KidInASquid/STeeringWheel/STeering_wheel.png

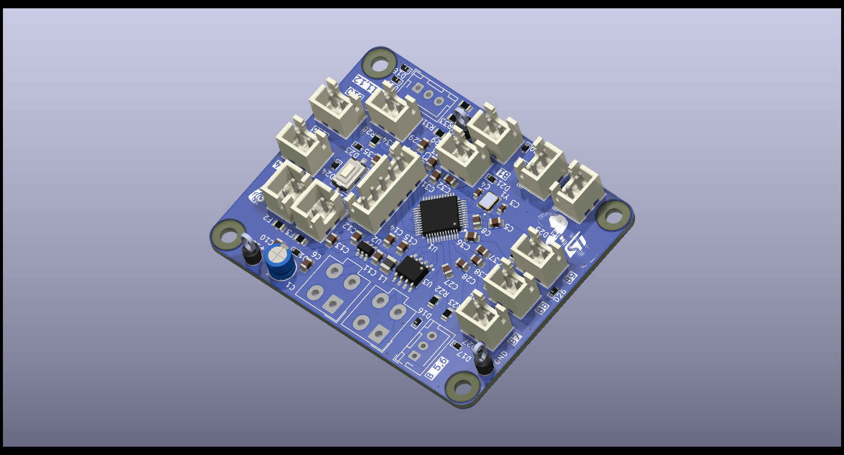
STeering_wheel.png
