KidInASquid/STeeringWheel/Base.step

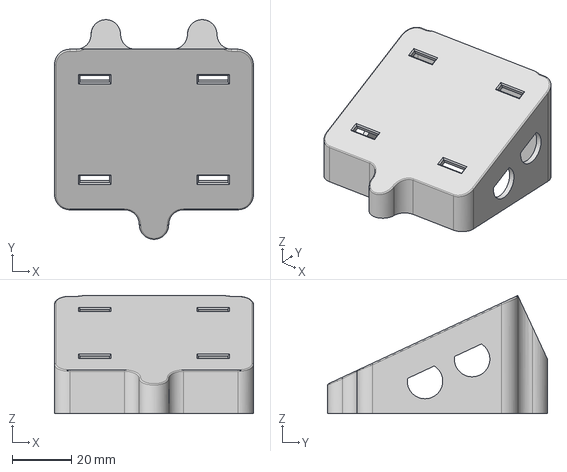
[picture p2: CAD file, 2025-04-29]
Base.step
67.4 x 74.4 x 40.0 mm
