KidInASquid/STeeringWheel/Lid.step

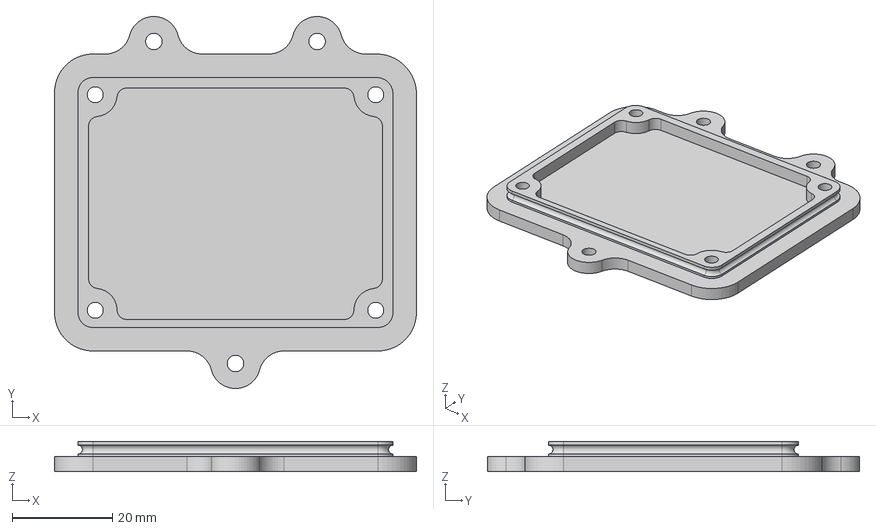
[picture p3: CAD file, 2025-04-29]
Lid.step
72.4 x 74.4 x 6.00 mm
