KidInASquid/STeeringWheel/PCB.pdf

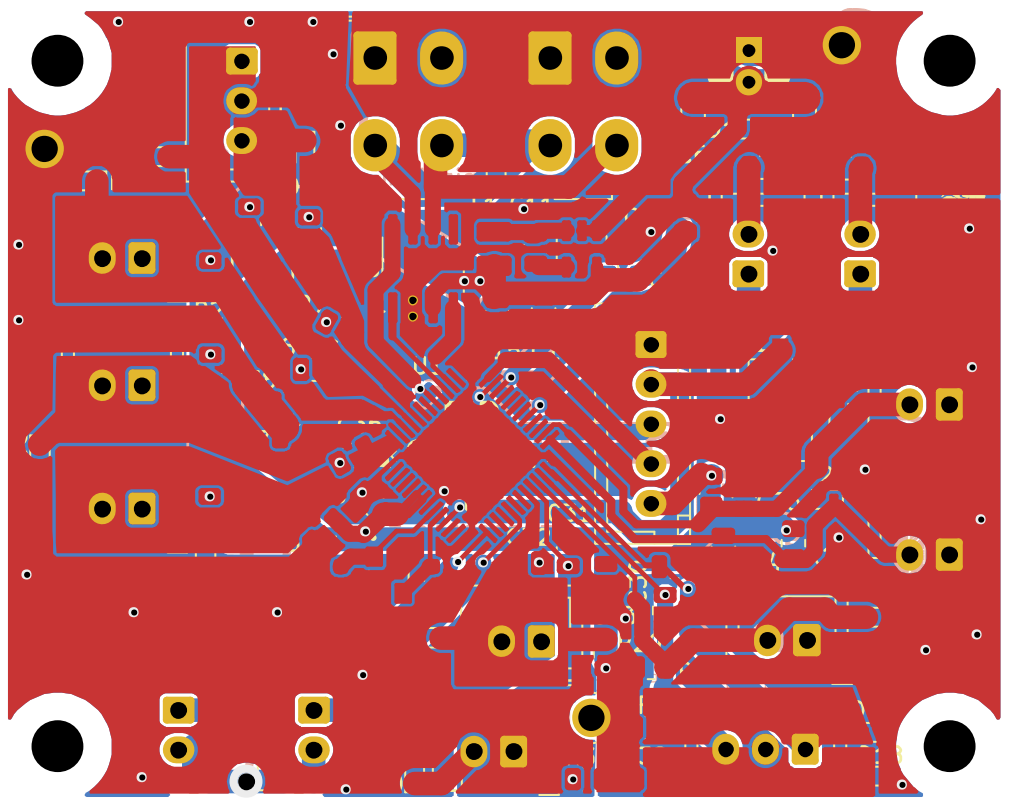
[picture p19: page 1]
