KidInASquid/STeeringWheel/KiCAD files/STeering_wheel.kicad_pcb

## KiCad design KiCAD files/STeering_wheel.kicad_pcb (2025-04-29)

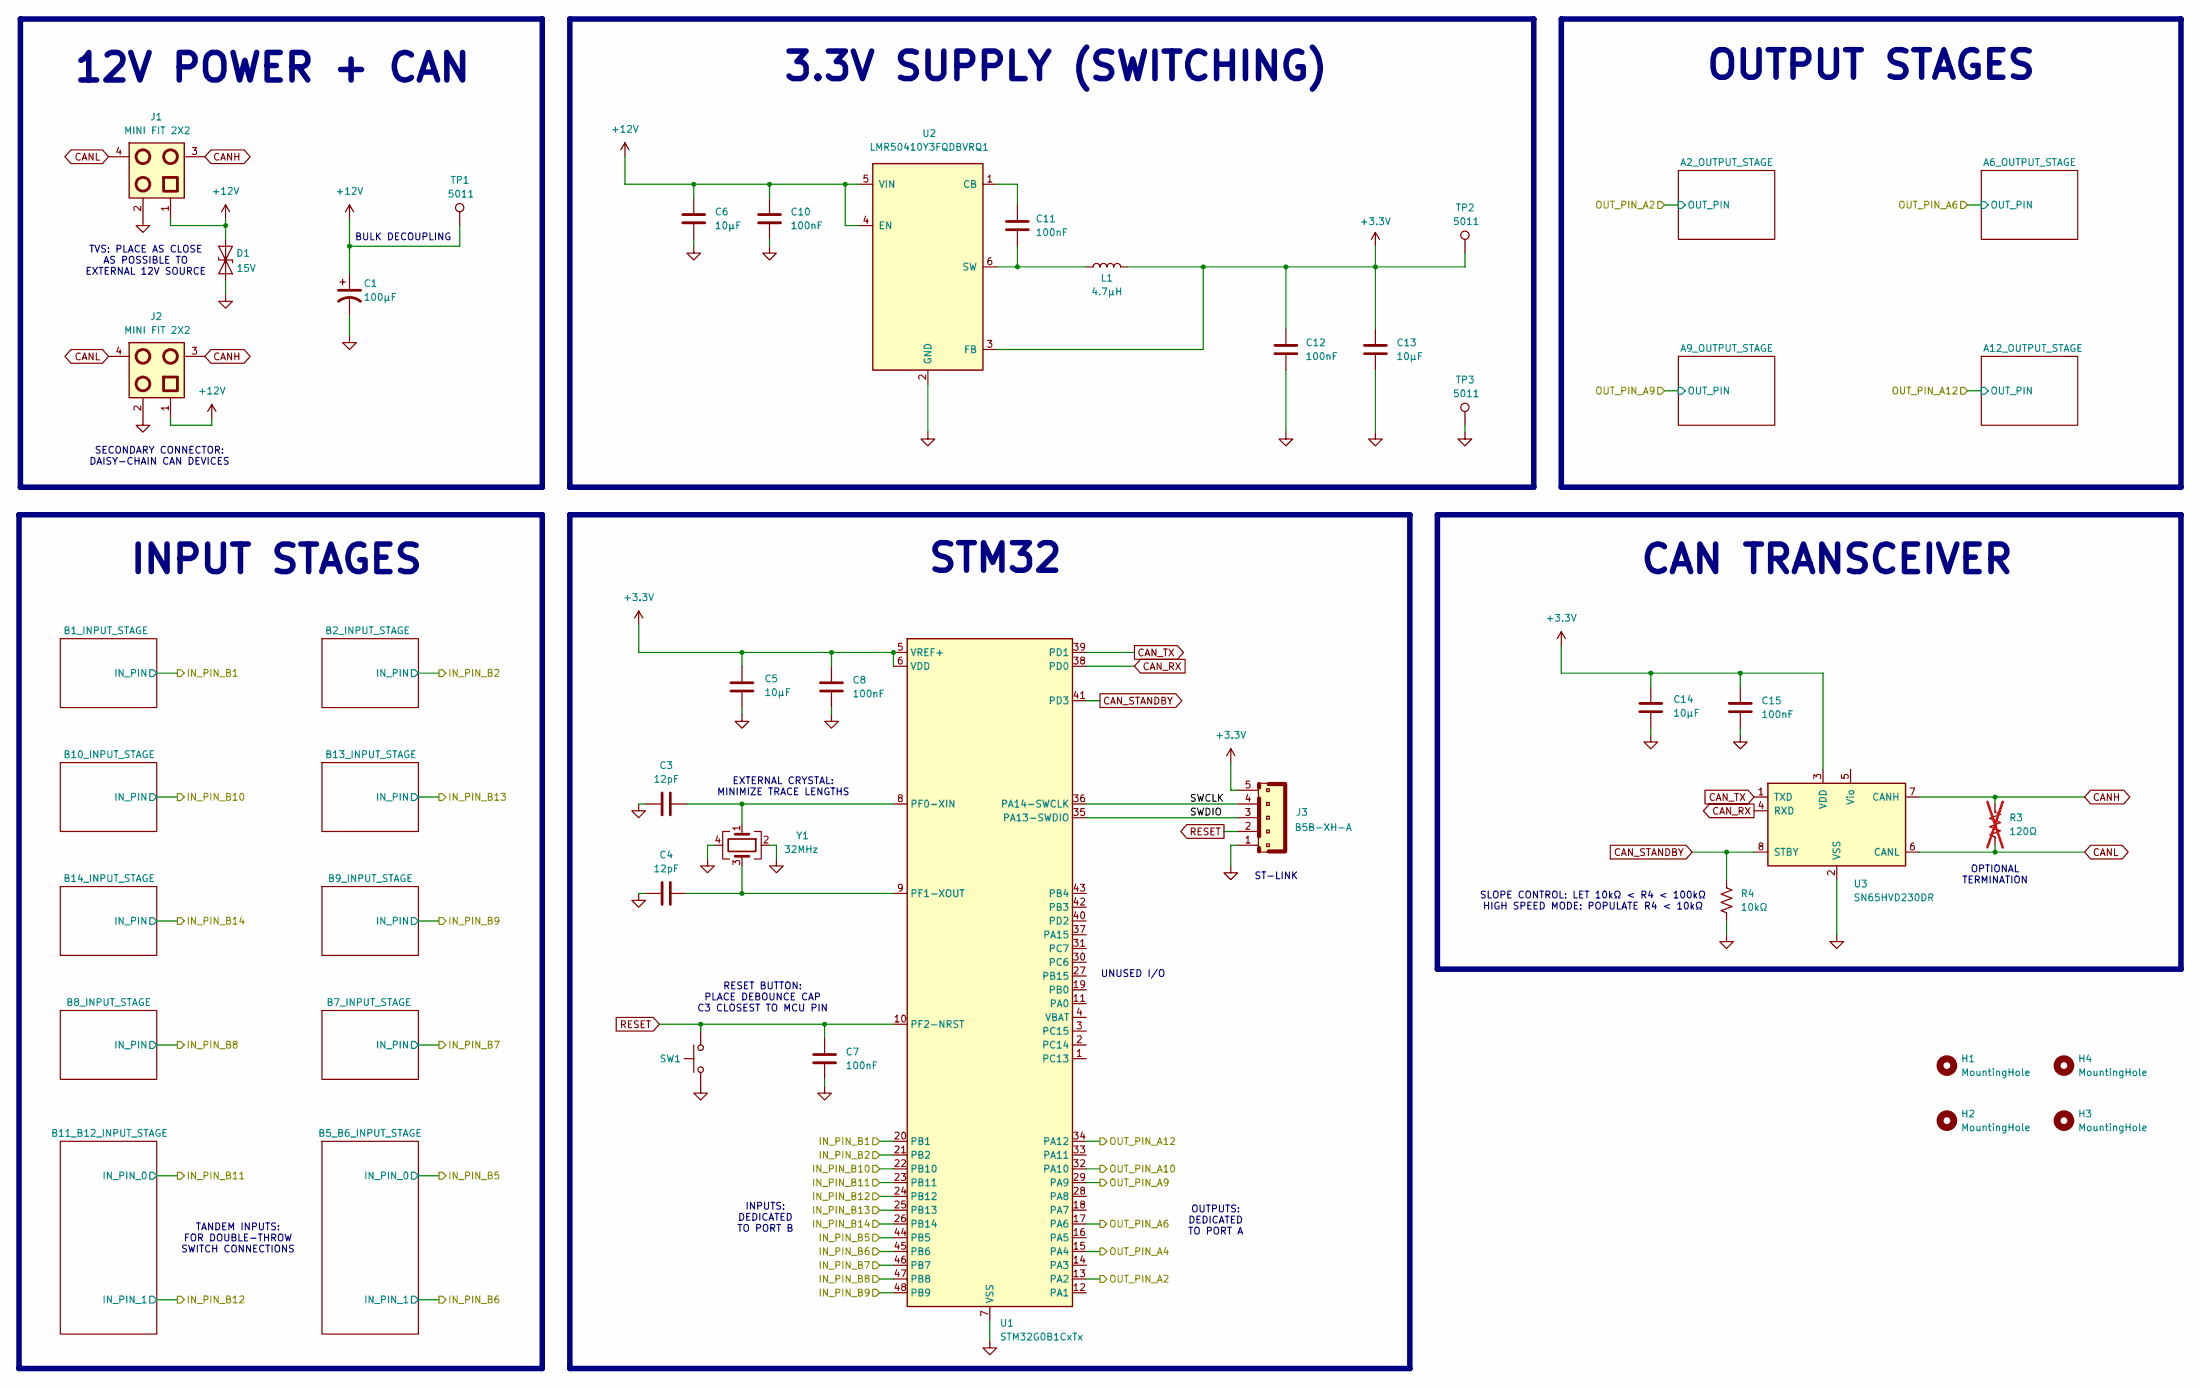
[picture p20: schematic STeering_wheel.kicad_sch, Steering Wheel STM32 CAN Module]

Parts:
C1: 100μF; CP_Radial_D5.0mm_P2.00mm; DigiKey Part Number P10369CT-ND
C3, C4: 12pF; C_0603_1608Metric; DigiKey Part Number 4713-CHV0805N250120FCT-ND
C5, C6, C13, C14: 10µF; C_0805_2012Metric; DigiKey Part Number 1276-1096-1-ND
C7, C8, C10, C11, C12, C15: 100nF; C_0805_2012Metric; DigiKey Part Number 1276-2442-1-ND
D1: AQHV15-01LTG-C; D_SOD-523; DigiKey Part Number AQHV15-01LTG-CCT-ND
H1, H2, H3, H4: MountingHole; MountingHole_3.2mm_M3_isolated_clearance
J1, J2: MINI FIT 2X2; Molex_Mini-Fit_Jr_5566-04A_2x02_P4.20mm_Vertical; DigiKey Part Number WM13112-ND
J3: B5B-XH-A; JST_XH_B5B-XH-A_1x05_P2.50mm_Vertical; DigiKey Part Number 455-B5B-XH-A-ND
L1: 4.7µH; L_1008_2520Metric; DigiKey Part Number 3526-WIP252010S-4R7MLDGCT-ND
R3: 120Ω; R_0805_2012Metric; DigiKey Part Number 2019-RK73H2ATTD1200FCT-ND; not fitted
R4: 10kΩ; R_0805_2012Metric; DigiKey Part Number 2019-RK73B2ATTD103JCT-ND
SW1: PTS636 SL50 SMTR LFS; SW_Tactile_SPST_NO_Straight_CK_PTS636Sx25SMTRLFS; DigiKey Part Number CKN12313-1-ND
TP1, TP2, TP3: 5011; keystone_5011_testpoint; DigiKey Part Number 36-5011-ND
U1: STM32G0B1CxTx; LQFP-48_7x7mm_P0.5mm; DigiKey Part Number 497-STM32G0B1KCT6-ND
U2: LMR50410Y3FQDBVRQ1; SOT-23-6; DigiKey Part Number 296-LMR50410Y3FQDBVRQ1CT-ND
U3: SN65HVD230DR; SOIC-8_3.9x4.9mm_P1.27mm_with_via_in_pads; DigiKey Part Number 296-11654-1-ND
Y1: 32MHz; XTAL_ECS-320-12-33B-7KM-TR; DigiKey Part Number 50-ECS-320-12-33B-7KM-CT-ND

Connections:
+3.3V: C5.1, C8.1, C12.1, C13.1, C14.1, C15.1, J3.5, L1.2, TP2.1, U1.5 (VREF+), U1.6 (VDD), U2.3 (FB), U3.3 (VDD); also elsewhere on the board
+12V: C1.1, C6.1, C10.1, D1.1 (A1), J1.1, J2.1, TP1.1, U2.4 (EN), U2.5 (VIN); also elsewhere on the board
/IN_PIN_B1: U1.20 (PB1); also elsewhere on the board
/IN_PIN_B2: U1.21 (PB2); also elsewhere on the board
/IN_PIN_B5: U1.44 (PB5); also elsewhere on the board
/IN_PIN_B6: U1.45 (PB6); also elsewhere on the board
/IN_PIN_B7: U1.46 (PB7); also elsewhere on the board
/IN_PIN_B8: U1.47 (PB8); also elsewhere on the board
/IN_PIN_B9: U1.48 (PB9); also elsewhere on the board
/IN_PIN_B10: U1.22 (PB10); also elsewhere on the board
/IN_PIN_B11: U1.23 (PB11); also elsewhere on the board
/IN_PIN_B12: U1.24 (PB12); also elsewhere on the board
/IN_PIN_B13: U1.25 (PB13); also elsewhere on the board
/IN_PIN_B14: U1.26 (PB14); also elsewhere on the board
/OUT_PIN_A2: U1.13 (PA2); also elsewhere on the board
/OUT_PIN_A4: U1.15 (PA4)
/OUT_PIN_A6: U1.17 (PA6); also elsewhere on the board
/OUT_PIN_A9: U1.29 (PA9); also elsewhere on the board
/OUT_PIN_A10: U1.32 (PA10)
/OUT_PIN_A12: U1.34 (PA12); also elsewhere on the board
/SWCLK: J3.4, U1.36 (PA14-SWCLK)
/SWDIO: J3.3, U1.35 (PA13-SWDIO)
CANH: J1.3, J2.3, R3.1, U3.7 (CANH)
CANL: J1.4, J2.4, R3.2, U3.6 (CANL)
CAN_RX: U1.38 (PD0), U3.4 (RXD)
CAN_STANDBY: R4.1, U1.41 (PD3), U3.8 (STBY)
CAN_TX: U1.39 (PD1), U3.1 (TXD)
GND: C1.2, C3.1, C4.1, C5.2, C6.2, C7.2, C8.2, C10.2, C12.2, C13.2, C14.2, C15.2, D1.2 (A2), J1.2, J2.2, J3.1, R4.2, SW1.1, TP3.1, U1.7 (VSS), U2.2 (GND), U3.2 (VSS), Y1.2, Y1.4; also elsewhere on the board
unnamed: C3.2, U1.8 (PF0-XIN), Y1.1
unnamed: C4.2, U1.9 (PF1-XOUT), Y1.3
unnamed: C11.1, U2.1 (CB)
unnamed: C11.2, L1.1, U2.6 (SW)
RESET: C7.1, J3.2, SW1.2, U1.10 (PF2-NRST)

Notes on the sheet:
3.3V SUPPLY (SWITCHING)
INPUTS: DEDICATED TO PORT B
12V POWER + CAN
EXTERNAL CRYSTAL: MINIMIZE TRACE LENGTHS
OUTPUT STAGES
OPTIONAL TERMINATION
CAN TRANSCEIVER
SECONDARY CONNECTOR: DAISY-CHAIN CAN DEVICES
OUTPUTS: DEDICATED TO PORT A
RESET BUTTON: PLACE DEBOUNCE CAP C3 CLOSEST TO MCU PIN
TVS: PLACE AS CLOSE AS POSSIBLE TO EXTERNAL 12V SOURCE
UNUSED I/O
STM32
SLOPE CONTROL: LET 10kΩ < R4 < 100kΩ HIGH SPEED MODE: POPULATE R4 < 10kΩ
BULK DECOUPLING
ST-LINK
TANDEM INPUTS: FOR DOUBLE-THROW SWITCH CONNECTIONS
INPUT STAGES

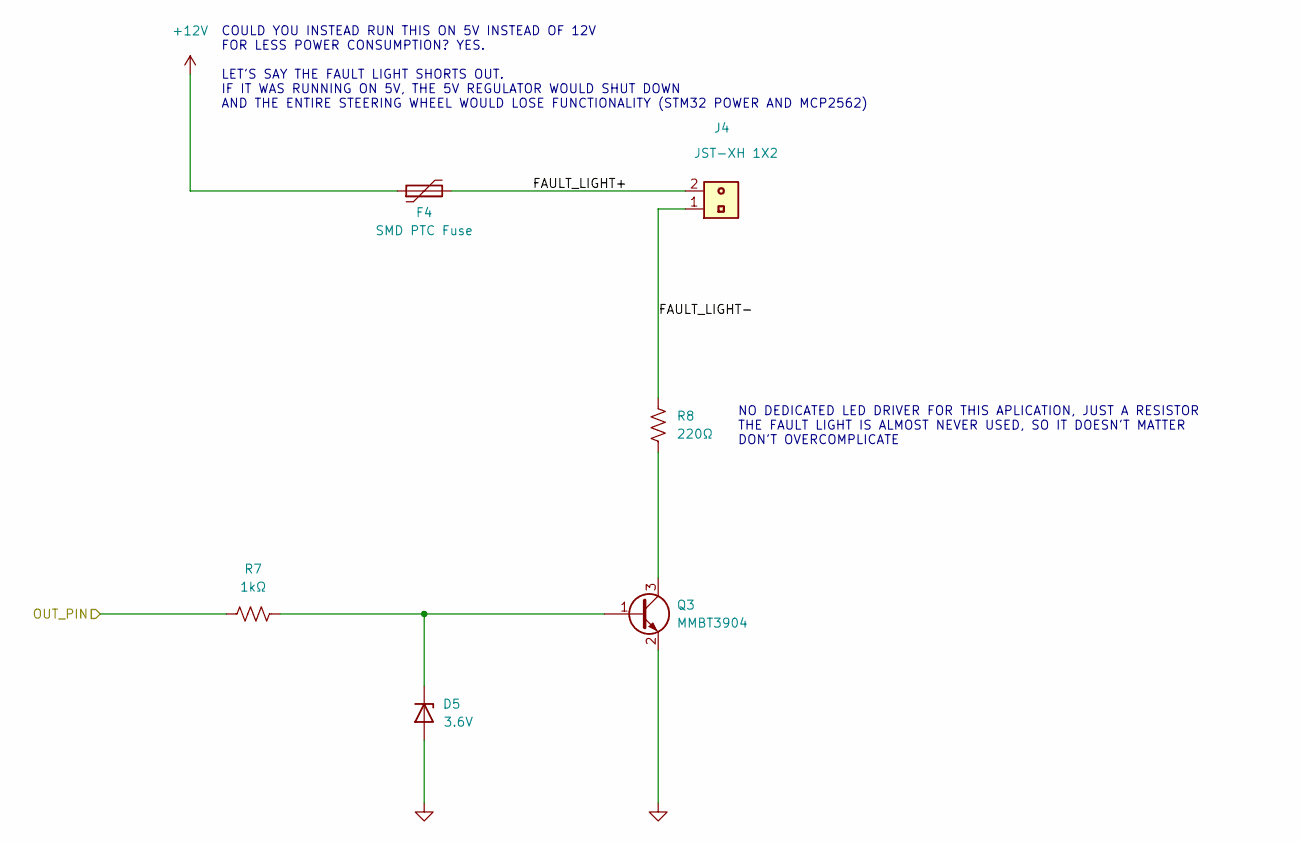
[picture p21: schematic FET_output_stage.kicad_sch, FET Output Stage]

Parts:
D5: ESD321DYAR; D_SOD-523; DigiKey Part Number 296-ESD321DYARCT-ND
F4: PRG21BC2R2MM1RA; Fuse_0805_2012Metric; DigiKey Part Number 490-8512-1-ND
J4: JST-XH 1X2; JST_XH_B2B-XH-AM_1x02_P2.50mm_Vertical; DigiKey Part Number WM14662-ND
Q3: MMBT3904; SOT-23; DigiKey Part Number 4530-MMBT3904CT-ND
R7: 1kΩ; R_0805_2012Metric; DigiKey Part Number 2019-RK73B2ATTD102JCT-ND
R8: 220Ω; R_0805_2012Metric

Connections:
+12V: F4.1; also elsewhere on the board
/A2_OUTPUT_STAGE/FAULT_LIGHT+: F4.2, J4.2
/A2_OUTPUT_STAGE/FAULT_LIGHT-: J4.1, R8.2
/OUT_PIN_A2: R7.1; also elsewhere on the board
GND: D5.2 (A), Q3.2 (E); also elsewhere on the board
unnamed: D5.1 (K), Q3.1 (B), R7.2
unnamed: Q3.3 (C), R8.1

Parts of its further copies:
D2, D3, D4: ESD321DYAR; D_SOD-523; DigiKey Part Number 296-ESD321DYARCT-ND
F1, F2, F3: PRG21BC2R2MM1RA; Fuse_0805_2012Metric; DigiKey Part Number 490-8512-1-ND
J5, J6, J7: JST-XH 1X2; JST_XH_B2B-XH-AM_1x02_P2.50mm_Vertical; DigiKey Part Number WM14662-ND
Q1, Q2, Q4: MMBT3904; SOT-23; DigiKey Part Number 4530-MMBT3904CT-ND
R1, R5, R9: 1kΩ; R_0805_2012Metric; DigiKey Part Number 2019-RK73B2ATTD102JCT-ND
R2, R6, R10: 220Ω; R_0805_2012Metric

Connections of its further copies:
+12V: F1.1, F2.1, F3.1; also elsewhere on the board
/A6_OUTPUT_STAGE/FAULT_LIGHT+: F1.2, J5.2
/A6_OUTPUT_STAGE/FAULT_LIGHT-: J5.1, R2.2
/A9_OUTPUT_STAGE/FAULT_LIGHT+: F2.2, J6.2
/A9_OUTPUT_STAGE/FAULT_LIGHT-: J6.1, R6.2
/A12_OUTPUT_STAGE/FAULT_LIGHT+: F3.2, J7.2
/A12_OUTPUT_STAGE/FAULT_LIGHT-: J7.1, R10.2
/OUT_PIN_A6: R1.1; also elsewhere on the board
/OUT_PIN_A9: R5.1; also elsewhere on the board
/OUT_PIN_A12: R9.1; also elsewhere on the board
GND: D2.2 (A), D3.2 (A), D4.2 (A), Q1.2 (E), Q2.2 (E), Q4.2 (E); also elsewhere on the board
unnamed: D2.1 (K), Q1.1 (B), R1.2
unnamed: D3.1 (K), Q2.1 (B), R5.2
unnamed: D4.1 (K), Q4.1 (B), R9.2
unnamed: Q1.3 (C), R2.1
unnamed: Q2.3 (C), R6.1
unnamed: Q4.3 (C), R10.1

Notes on the sheet:
NO DEDICATED LED DRIVER FOR THIS APLICATION, JUST A RESISTOR THE FAULT LIGHT IS ALMOST NEVER USED, SO IT DOESN'T MATTER DON'T OVERCOMPLICATE
COULD YOU INSTEAD RUN THIS ON 5V INSTEAD OF 12V FOR LESS POWER CONSUMPTION? YES. LET'S SAY THE FAULT LIGHT SHORTS OUT. IF IT WAS RUNNING ON 5V, THE 5V REGULATOR WOULD SHUT DOWN AND THE ENTIRE STEERING WHEEL WOULD LOSE FUNCTIONALITY (STM32 POWER AND MCP2562)

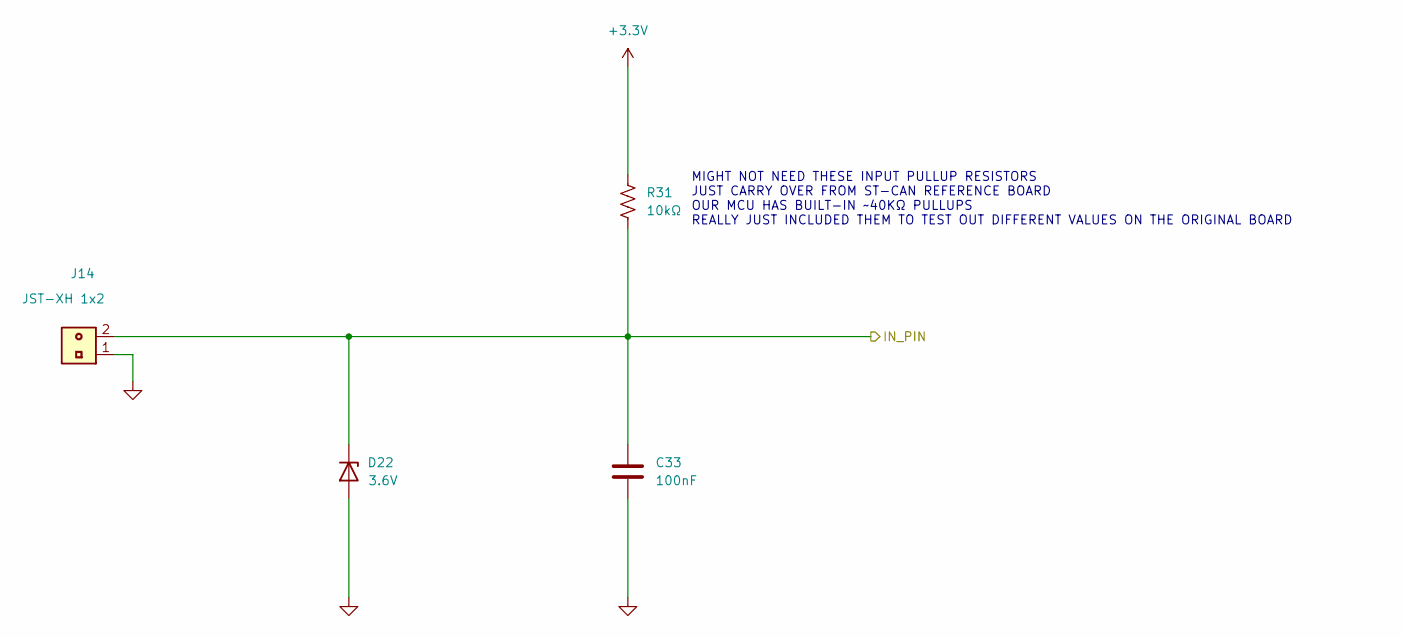
[picture p22: schematic input_stage.kicad_sch, Digital Input Stage]

Parts:
C33: 100nF; C_0805_2012Metric; DigiKey Part Number 1276-2442-1-ND
D22: ESD321DYAR; D_SOD-523; DigiKey Part Number 296-ESD321DYARCT-ND
J14: JST-XH 1x2; JST_XH_B2B-XH-AM_1x02_P2.50mm_Vertical; DigiKey Part Number WM14662-ND
R31: 10kΩ; R_0805_2012Metric; DigiKey Part Number 2019-RK73B2ATTD103JCT-ND

Connections:
+3.3V: R31.1; also elsewhere on the board
/IN_PIN_B10: C33.1, D22.1 (K), J14.2, R31.2; also elsewhere on the board
GND: C33.2, D22.2 (A), J14.1; also elsewhere on the board

Parts of its further copies:
C31, C32, C34, C35, C36, C37, C38: 100nF; C_0805_2012Metric; DigiKey Part Number 1276-2442-1-ND
D20, D21, D23, D24, D25, D26, D27: ESD321DYAR; D_SOD-523; DigiKey Part Number 296-ESD321DYARCT-ND
J12, J13, J15, J16, J17, J18, J19: JST-XH 1x2; JST_XH_B2B-XH-AM_1x02_P2.50mm_Vertical; DigiKey Part Number WM14662-ND
R24, R25, R26, R27, R28, R29, R30: 10kΩ; R_0805_2012Metric; DigiKey Part Number 2019-RK73B2ATTD103JCT-ND

Connections of its further copies:
+3.3V: R24.1, R25.1, R26.1, R27.1, R28.1, R29.1, R30.1; also elsewhere on the board
/IN_PIN_B1: C32.1, D21.1 (K), J13.2, R29.2; also elsewhere on the board
/IN_PIN_B2: C31.1, D20.1 (K), J12.2, R30.2; also elsewhere on the board
/IN_PIN_B7: C38.1, D27.1 (K), J19.2, R24.2; also elsewhere on the board
/IN_PIN_B8: C37.1, D26.1 (K), J18.2, R25.2; also elsewhere on the board
/IN_PIN_B9: C36.1, D25.1 (K), J17.2, R26.2; also elsewhere on the board
/IN_PIN_B13: C34.1, D23.1 (K), J15.2, R28.2; also elsewhere on the board
/IN_PIN_B14: C35.1, D24.1 (K), J16.2, R27.2; also elsewhere on the board
GND: C31.2, C32.2, C34.2, C35.2, C36.2, C37.2, C38.2, D20.2 (A), D21.2 (A), D23.2 (A), D24.2 (A), D25.2 (A), D26.2 (A), D27.2 (A), J12.1, J13.1, J15.1, J16.1, J17.1, J18.1, J19.1; also elsewhere on the board

Notes on the sheet:
MIGHT NOT NEED THESE INPUT PULLUP RESISTORS JUST CARRY OVER FROM ST-CAN REFERENCE BOARD OUR MCU HAS BUILT-IN ~40KΩ PULLUPS REALLY JUST INCLUDED THEM TO TEST OUT DIFFERENT VALUES ON THE ORIGINAL BOARD

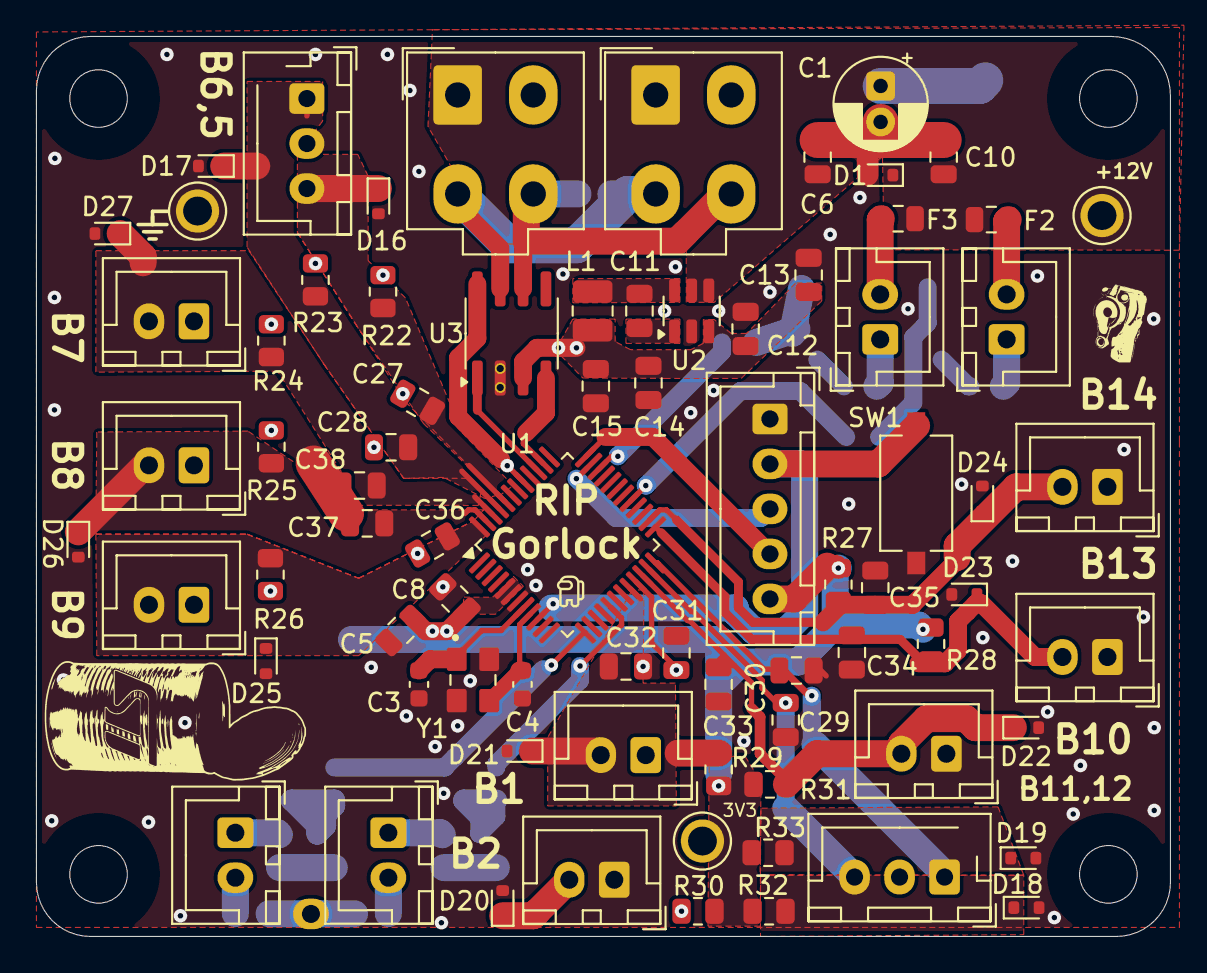
[picture p23: board STeering_wheel.kicad_pcb from above]

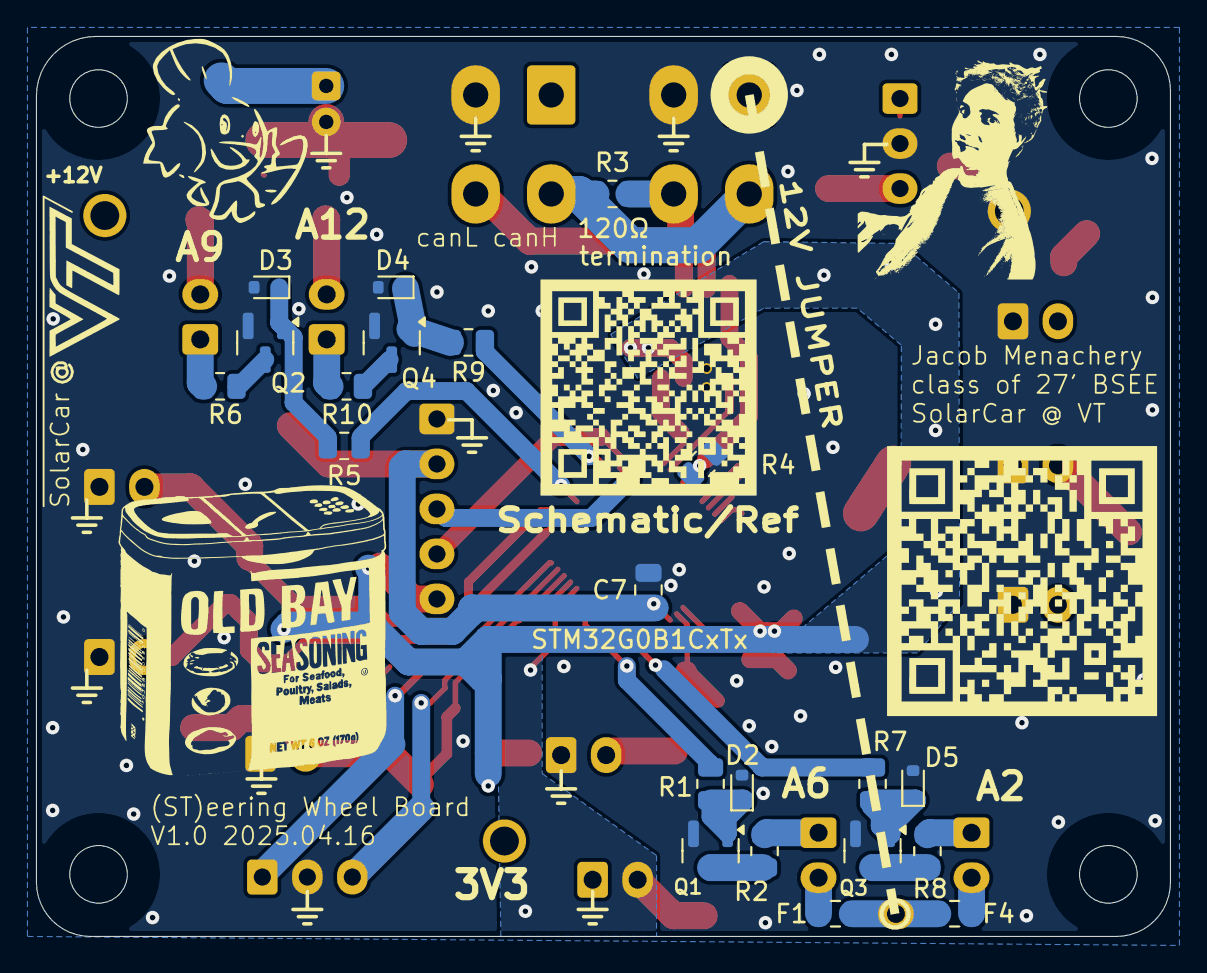
[picture p24: board STeering_wheel.kicad_pcb from below]

Board: 2 copper layers, 63.0 x 50.0 mm, 102 parts (21 on the bottom side), 47 nets.

Other parts of the board:
C27, C28, C29, C30: 100nF; C_0805_2012Metric
D16, D17, D18, D19: ESD321DYAR; D_SOD-523
J10, J11: JST-XH1X3; JST_XH_B3B-XH-AM_1x03_P2.50mm_Vertical
R22, R23, R32, R33: 10kΩ; R_0805_2012Metric

Their connections:
+3.3V: R22.1, R23.1, R32.1, R33.1; also elsewhere on the board
/IN_PIN_B5: C27.1, D16.1 (K), J10.3, R22.2; also elsewhere on the board
/IN_PIN_B6: C28.1, D17.1 (K), J10.1, R23.2; also elsewhere on the board
/IN_PIN_B11: C29.1, D18.1 (K), J11.3, R32.2; also elsewhere on the board
/IN_PIN_B12: C30.1, D19.1 (K), J11.1, R33.2; also elsewhere on the board
GND: C27.2, C28.2, C29.2, C30.2, D16.2 (A), D17.2 (A), D18.2 (A), D19.2 (A), J10.2, J11.2; also elsewhere on the board
